Mines-Rocketry-Club/flight-computers/the_timer/timer V0.0.2.step

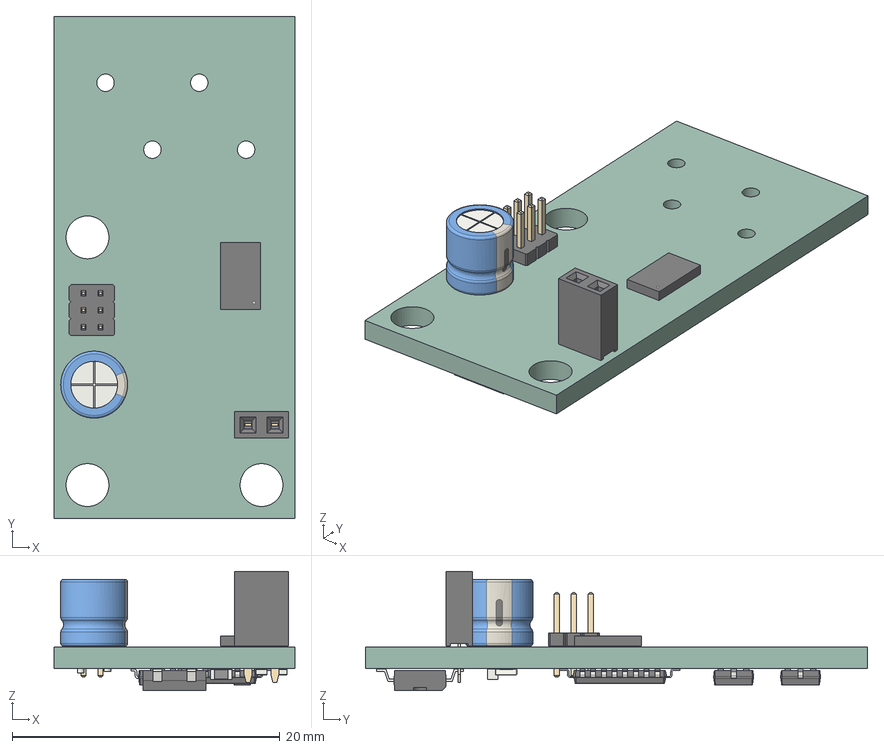
[picture p1: CAD file, 2024-05-01]
the_timer/timer V0.0.2.step
18.0 x 37.5 x 8.93 mm
CP_Radial_D50mm_P200mm
LGA_8_3x5mm_P125mm
PinHeader_2x03_P127mm_Vertical
PinSocket_1x02_P200mm_Vertical
SOT_23 x 3
TQFP_32_7x7mm_P08mm
TO-269AA
L_0603_1608Metric
R_0603_1608Metric x 2
timer_PCB
