Mines-Rocketry-Club/flight-computers/(commit log)

2024-04-09 init new projects, bring in the timers
    [screamer.kicad_pcb, screamer.kicad_sch, the_guesser.kicad_pcb, the_guesser.kicad_sch, the_knower.kicad_pcb, the_knower.kicad_sch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]
2024-04-09 begin project resource library
    [the_guesser.kicad_pcb, the_guesser.kicad_sch]
2024-04-09 added memory to the timer
    [timer.kicad_pcb, timer.kicad_sch]
2024-04-09 added missing footprint library
2024-04-10 Finished rerouting timer
    [timer.kicad_pcb, timer.kicad_sch]
2024-04-10 began work on guesser schematics
    [the_guesser.kicad_sch]
2024-04-10 created project common symbols library & guesser work
    [the_guesser.kicad_sch]
2024-04-11 placed several chips
    [the_guesser.kicad_sch]
2024-04-11 work on the screamer and some R analysis code
    [screamer.kicad_sch, the_guesser.kicad_sch]
2024-04-11 commit to defuck the libraries
    [screamer.kicad_sch]
2024-04-12 Updates to Timer
    fuckkkkkkkkkkkkkkkkkkk
    [timer.kicad_pcb, timer.kicad_sch]
2024-04-12 screamer sch work
    [screamer.kicad_sch]
2024-04-12 final screamer schematics
    [screamer.kicad_sch]
2024-04-12 Timer is "done"
    [timer.kicad_pcb, timer.kicad_sch]
2024-04-12 i moved a trace .2mm
    [timer.kicad_pcb]
2024-04-13 added second battery terminal
    [timer.kicad_pcb, timer.kicad_sch]
2024-04-15 The squincher did the squinch
    [screamer.kicad_pcb, screamer.kicad_sch]
2024-04-15 Added connector to Screamer
    [screamer.kicad_pcb, screamer.kicad_sch]
2024-04-15 Cleaned up Screamer vias
    Also this is a reminder to NOT TOUCH the new "locals_but_working_PLEASE.pretty" folder that I created.
    [screamer.kicad_pcb]
2024-04-16 De-squinched the Screamer
    Board is now 18x14 mm. I also moved the antenna position and cleaned up the silkscreen.
    [screamer.kicad_pcb, screamer.kicad_sch]
2024-04-16 Adjusted Screamer vias
    [screamer.kicad_pcb]
2024-04-16 hell hell hell hell hell hell hell hell hell
    updated timer to have a better layout and header pins. This layout is NOT yet screamer compatible and is not final
    [timer.kicad_pcb, timer.kicad_sch]
2024-04-16 inner: resolve
    [timer.kicad_pcb, timer.kicad_sch]
2024-04-16 work on the screamer and some R analysis code inner inner fix merge
    [screamer.kicad_sch]
2024-04-16 potential fix for broken kicad files
2024-04-19 Guesser now works with timer
    :3
2024-04-20 Added Timer power connector
    [screamer.kicad_pcb, screamer.kicad_sch]
2024-04-20 Make the github fucking work
    [timer.kicad_pcb, timer.kicad_sch]
2024-04-20 Added resistor values to the voltage divider
    The resistors are 681 ohms and 1.2k ohms. I also adjusted some stuff on the silkscreen to make it more readable.
    [screamer.kicad_pcb, screamer.kicad_sch]
2024-04-23 Started on Timer code
2024-04-23 Revert "Merge branch 'main' of https://github.com/CSM-Rocketry-Club/flight-computers"
    This reverts commit 3edd037536e7f8eb1c97200e83282850b3e66c85, reversing
    changes made to 45bb795bdd8a498dcdd2092ff2f1a03ff2b1d69a.
    [screamer.kicad_pcb, screamer.kicad_sch]
2024-04-23 Revert "Started on Timer code"
    This reverts commit 45bb795bdd8a498dcdd2092ff2f1a03ff2b1d69a.
    [FlightComputer.cpp, PyroCharge.cpp, main.cpp]
2024-04-23 Started on the Timer code (for real)
    updated the gitignore!
2024-04-24 repair timer files from the merge
    [timer.kicad_pcb, timer.kicad_sch]
2024-04-24 More work on fleshing out timer code
2024-04-30 Further timer updates
    [timer.kicad_pcb]
2024-05-01 Created 3D models of V0.0.2 Screamer and Timer
    [screamer V0.0.2.step, timer V0.0.2.step]
2024-05-02 basic timer code done. needs I2C and flash storage still
2024-05-02 Revert "Merge branch 'main' of https://github.com/Mines-Rocketry-Club/flight-computers"
    This reverts commit 078ac57e77fd6677f6dff357334dcf35e5addb3e, reversing
    changes made to e052295e3eeb9c2af4a3152dedf6dc0942ce3b9b.
    [screamer V0.0.2.step, timer V0.0.2.step]
2024-05-02 Revert "basic timer code done. needs I2C and flash storage still"
    This reverts commit e052295e3eeb9c2af4a3152dedf6dc0942ce3b9b.
    [Accelerometer.cpp, Altimeter.h, Altimiter.cpp, FlightComputer.cpp, FlightComputer.h, PyroCharge.cpp, PyroCharge.h, main.cpp]
2024-05-02 Reapply "Merge branch 'main' of https://github.com/Mines-Rocketry-Club/flight-computers"
    This reverts commit 4217abac3257780637590a0b5727a620ce2e86cf.
    [screamer V0.0.2.step, timer V0.0.2.step]
2024-05-02 Reapply "basic timer code done. needs I2C and flash storage still"
    This reverts commit 842fa8577128e955ada3ada55c12d659330da4eb.
    [Accelerometer.cpp, Altimeter.h, Altimiter.cpp, FlightComputer.cpp, FlightComputer.h, PyroCharge.cpp, PyroCharge.h, main.cpp]
2024-05-02 Updated Screamer to V0.0.3
    Swapped VCO to MAX2623, adjusted filtering capacitors, and rerouted board.
    [screamer.kicad_pcb, screamer.kicad_sch]
2024-05-03 Adjusted Screamer RF OUT trace width
    Inductance is weird.
    [screamer.kicad_pcb]
2024-05-07 Added decoupling cap to barometer and rotated IMU 45 deg
    [timer.kicad_pcb, timer.kicad_sch]
2024-05-08 Add Screamer passive component part numbers
    [screamer V0.0.2.step, screamer.kicad_pcb, screamer.kicad_sch]
2024-05-08 Updated barometer decoupling cap DKPN
    [timer.kicad_pcb, timer.kicad_sch]
2024-05-08 Standardized names on Timer schematic
    [timer.kicad_pcb, timer.kicad_sch]
2024-05-10 gathered data on pyro charges
    [timer.kicad_sch]
2024-05-12 pyro charge analysis work
2024-05-13 Updated timer PCB
    this might just be the worst board ever made
    [timer.kicad_pcb, timer.kicad_sch]
2024-05-14 Progress on altimeter implementation
    [timer.kicad_pcb]
2024-05-14 Added datasheets to Timer schematic
    [timer.kicad_pcb, timer.kicad_sch]
2024-05-15 Adjusted Timer labels
    [timer.kicad_pcb, timer.kicad_sch]
2024-05-15 Replaced Timer mosfets
    [timer.kicad_pcb, timer.kicad_sch]
2024-05-16 Generated Screamer and Timer BOMs
    Both Screamer and Timer have been bumped to V0.1.
    [screamer.kicad_pcb, screamer.kicad_sch, timer.kicad_pcb, timer.kicad_sch]
2024-05-16 Fixed custom symbol file paths
    In addition to fixing all the file paths I also updated some symbols on the Timer and Screamer, updated the board characteristic tables, added missing 3D models to some components, and did a bit of other file stuff.
    [Transciever.kicad_sch, screamer.kicad_pcb, screamer.kicad_sch, the_guesser.kicad_sch, timer.kicad_pcb, timer.kicad_sch]
2024-05-16 Deleted redundant custom symbols and footprints
2024-05-16 Added automatic revision label to PCBs
    [screamer.kicad_pcb, timer.kicad_pcb]
2024-05-17 Started on Guesser transmitter schematic
    [Guesser_Transciever.kicad_sch, Transciever.kicad_sch, the_guesser.kicad_pcb, the_guesser.kicad_sch]
2024-05-17 Tweaked timer traces a bit
    [timer.kicad_pcb, timer.kicad_sch]
2024-05-17 Routed Guesser RF components
    [Guesser_Transciever.kicad_sch, the_guesser.kicad_pcb]
2024-05-17 Minor change to FlightComputer.cpp that didn't get pushed
    [FlightComputer.cpp]
2024-05-18 Started Guesser sensor selection
    [Guesser_Sensors.kicad_sch, Guesser_Transciever.kicad_sch, the_guesser.kicad_pcb, the_guesser.kicad_sch]
2024-05-19 Started Guesser I/O and continued sensor selection
    [Guesser_IO.kicad_sch, Guesser_Sensors.kicad_sch, Guesser_Transciever.kicad_sch, the_guesser.kicad_pcb, the_guesser.kicad_sch]
2024-05-20 Finished Guesser sensor selection and started sensor routing
    [Guesser_IO.kicad_sch, Guesser_Sensors.kicad_sch, Guesser_Transciever.kicad_sch, the_guesser.kicad_pcb, the_guesser.kicad_sch]
2024-05-22 Routed USB and SPI buses
    [Guesser_IO.kicad_sch, Guesser_Sensors.kicad_sch, Guesser_Transciever.kicad_sch, the_guesser.kicad_pcb, the_guesser.kicad_sch]
2024-05-22 Routed Guesser pyro channels
    [Guesser_IO.kicad_sch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]
2024-05-22 Finished routing Guesser
    [Guesser_IO.kicad_sch, Guesser_Transciever.kicad_sch, the_guesser.kicad_pcb, the_guesser.kicad_sch]
2024-05-22 Started Timer Programmer
    [Guesser_IO.kicad_sch, the_guesser.kicad_pcb, timer_programmer.kicad_pcb, timer_programmer.kicad_sch]
2024-05-23 Finished routing Timer Programmer
    [Guesser_IO.kicad_sch, Guesser_Sensors.kicad_sch, Guesser_Transciever.kicad_sch, the_guesser.kicad_pcb, the_guesser.kicad_sch, timer_programmer.kicad_pcb, timer_programmer.kicad_sch]
2024-05-23 Adjusted some Guesser vias
    [the_guesser.kicad_pcb]
2024-05-27 Redesigned Timer Programmer
    [timer.kicad_pcb, timer.kicad_sch, timer_programmer.kicad_pcb, timer_programmer.kicad_sch]
2024-05-27 Cleaned up Guesser schematic a bit
    [Guesser_IO.kicad_sch, Guesser_Sensors.kicad_sch, Guesser_Transciever.kicad_sch, the_guesser.kicad_pcb, the_guesser.kicad_sch]
2024-05-28 Created the Pointer
    The Pointer schematic is derived from the V0.0.10 Guesser.
    [Pointer_IO.kicad_sch, Pointer_Sensors.kicad_sch, Pointer_Transciever.kicad_sch, the_pointer.kicad_pcb, the_pointer.kicad_sch]
2024-05-29 Routed Pointer RF transmitter
    [Pointer_IO.kicad_sch, Pointer_Sensors.kicad_sch, Pointer_Transciever.kicad_sch, the_pointer.kicad_pcb, the_pointer.kicad_sch]
2024-05-29 Routed Pointer GPS
    [the_pointer.kicad_pcb, the_pointer.kicad_sch]
2024-05-30 Swapped Pointer to ESP32-C3FH4
    [Pointer_IO.kicad_sch, Pointer_Sensors.kicad_sch, Pointer_Transciever.kicad_sch, the_pointer.kicad_pcb, the_pointer.kicad_sch]
2024-05-30 Continued routing Pointer
    [the_pointer.kicad_pcb]
2024-05-30 Updated Guesser USB and GPS
    [Guesser_IO.kicad_sch, Guesser_Sensors.kicad_sch, Guesser_Transciever.kicad_sch, Pointer_IO.kicad_sch, the_guesser.kicad_pcb, the_guesser.kicad_sch]
2024-06-02 Accelerometer code nearing completion
    [timer.kicad_pcb]
2024-07-18 first pass on schematics. revisions to follow with pcb.
    [the_repeater.kicad_pcb, the_repeater.kicad_sch]
2024-09-04 Updated The Pointer???
    I don't actually know why it thinks I made a change but after every single time I open KiCad GitHub thinks that it's changed even though I haven't actually changed it so I'm just doing this to make GitHub shut up.
